danukingg/Line-Follower_PID_Robot/Hardware/PCB_Control.png

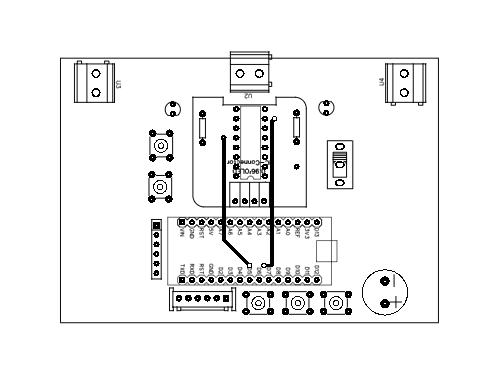
Hardware/PCB_Control.png
