danukingg/Line-Follower_PID_Robot/Hardware/PCB_Control_3D.png

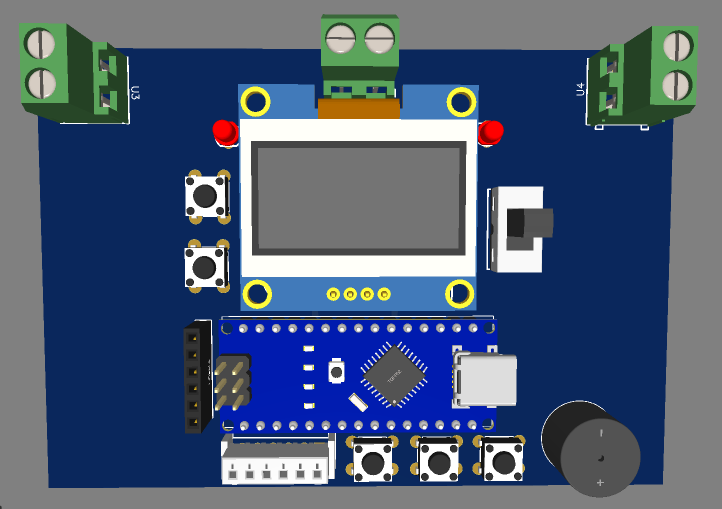
Hardware/PCB_Control_3D.png
