danukingg/Line-Follower_PID_Robot/Hardware/PCB_Control_Routing.png

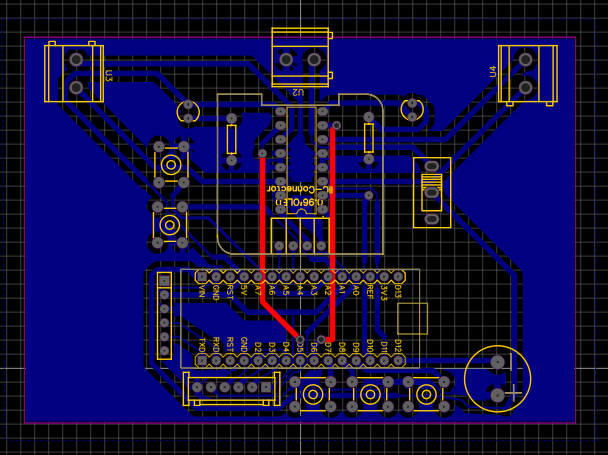
Hardware/PCB_Control_Routing.png
