danukingg/Line-Follower_PID_Robot/Hardware/PCB_Control_Schematics.png

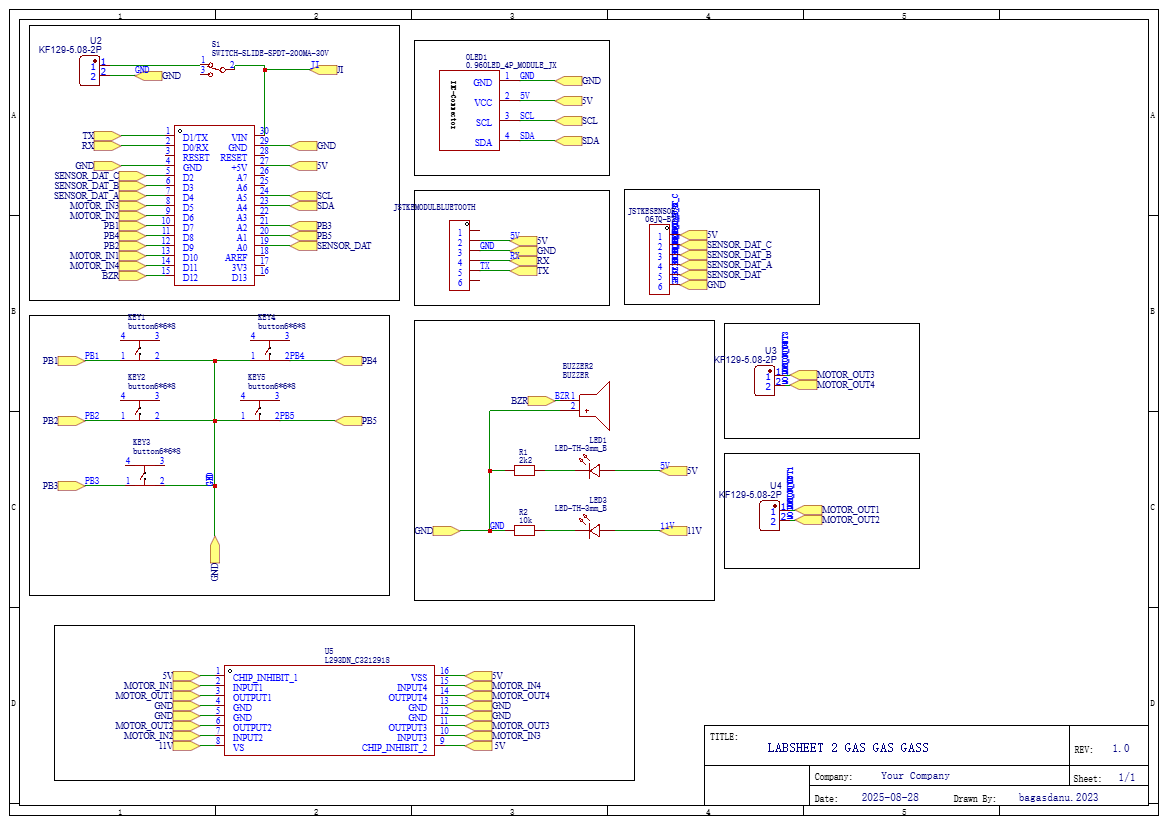
Hardware/PCB_Control_Schematics.png
