danukingg/Line-Follower_PID_Robot/Hardware/PCB_Sensor.png

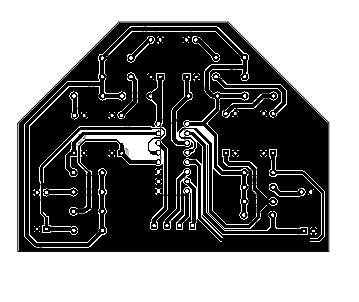
Hardware/PCB_Sensor.png
