danukingg/Line-Follower_PID_Robot/Hardware/PCB_Sensor_3D.png

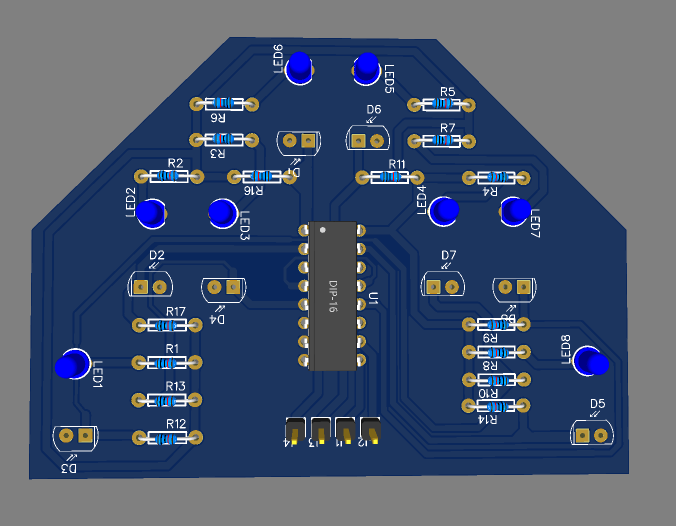
Hardware/PCB_Sensor_3D.png
