danukingg/Line-Follower_PID_Robot/Hardware/PCB_Sensor_Routing.png

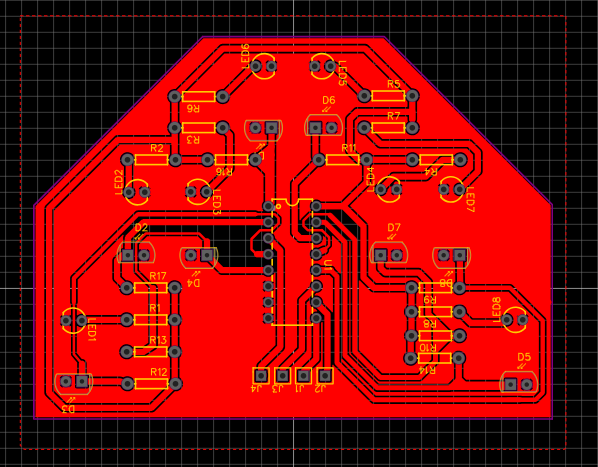
Hardware/PCB_Sensor_Routing.png
