danukingg/Line-Follower_PID_Robot/Hardware/PCB_Sensor_Schematics.png

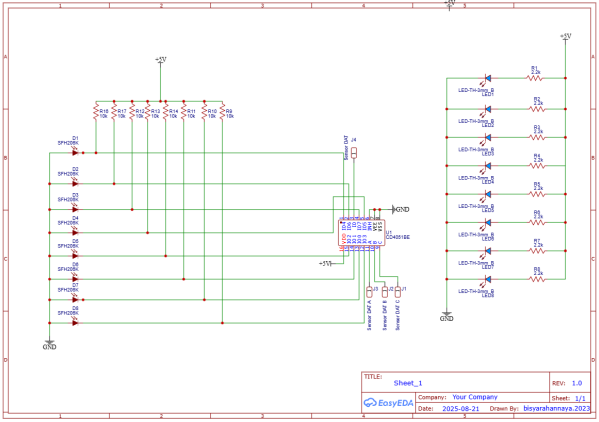
Hardware/PCB_Sensor_Schematics.png
