danukingg/Line-Follower_PID_Robot/Mechanical/3D Render Bottom View.png

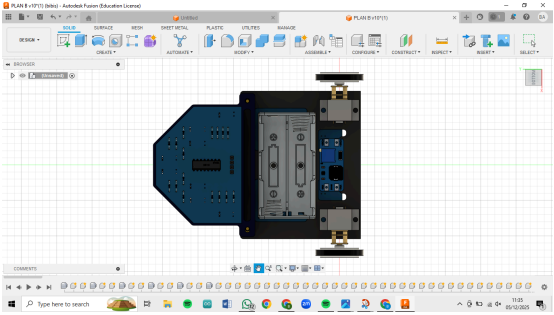
Mechanical/3D Render Bottom View.png
