danukingg/Line-Follower_PID_Robot/Mechanical/3D Render Top View.png

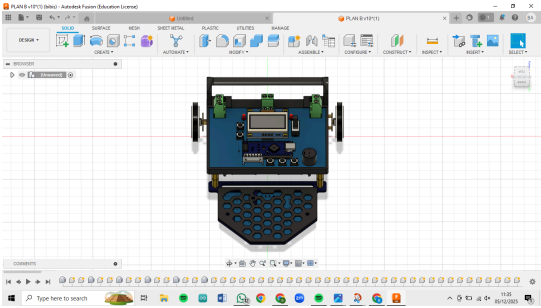
Mechanical/3D Render Top View.png
