danukingg/Line-Follower_PID_Robot/(commit log)

2025-12-17 Initialize README for PID Line Follower Robot
    Add project details for PID Line Follower Robot including specifications and control logic.
2025-12-18 Revise README for clarity and additional details
    Updated README to enhance clarity and detail about the project, including improvements in the PID control section and hardware specifications.
